vicatcu/BME680_Breakout/BME680/Board_with_RefDes.png

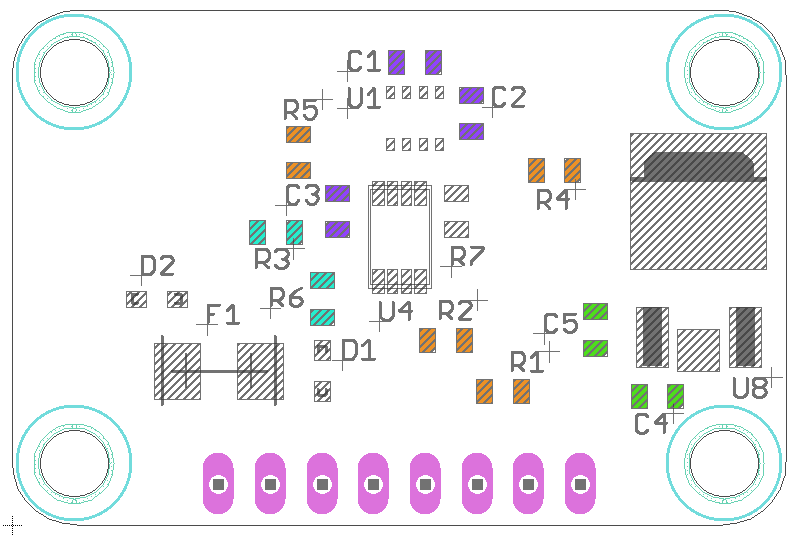
BME680/Board_with_RefDes.png
