vicatcu/BME680_Breakout/BME680/BOM.xlsx

LI | Qty | Designators | Manufacturer P/N | CType | Description
1 | 1 | U4 | NXP PCA9515ADP,118 | IC | I2C Multiplexer
2 | 1 | F1 | Bel Fuse Inc 0ZCG0014FF2C | Misc | PTC resettable fuse
3 | 1 | D2 | Diodes Inc. DDZ3V3BSF-7 | Diode | 3.43V Zener Diode
4 | 1 | D1 | Fairchild Semiconductor 1N4148WS | Diode | 1N4148 Diode
5 | 1 | C4, C5 | Kemet C0805C106K8PACTU | Capacitor | 10uF 0805 Capacitor
6 | 1 | U1 | Bosch Sensortec BME680 | Sensor | VOC Sensor
7 | 1 | U8 | STMicroelectronics LD1117DT33CTR | Power | 3.3V Regulator
8 | 3 | C1, C2, C3 | Yageo CC0805ZRY5V9BB104 | Capacitor | 0.1uF 0805 Capacitor
9 | 2 | R3, R6 | Yageo RC0805JR-0710KL | Resistor | 10k 0805 Resistor
10 | 1 | JP1 | 4UCON 00811 | Header | 1x8 Male Header
11 | 4 | R1, R2, R4, R5 | Yageo RC0805JR-074K7L | Resistor | 4.7kOhm 0805 Resistor
