vicatcu/BME680_Breakout/BME680_Breakout.brd

## EAGLE design BME680_Breakout.brd (2017-03-06)

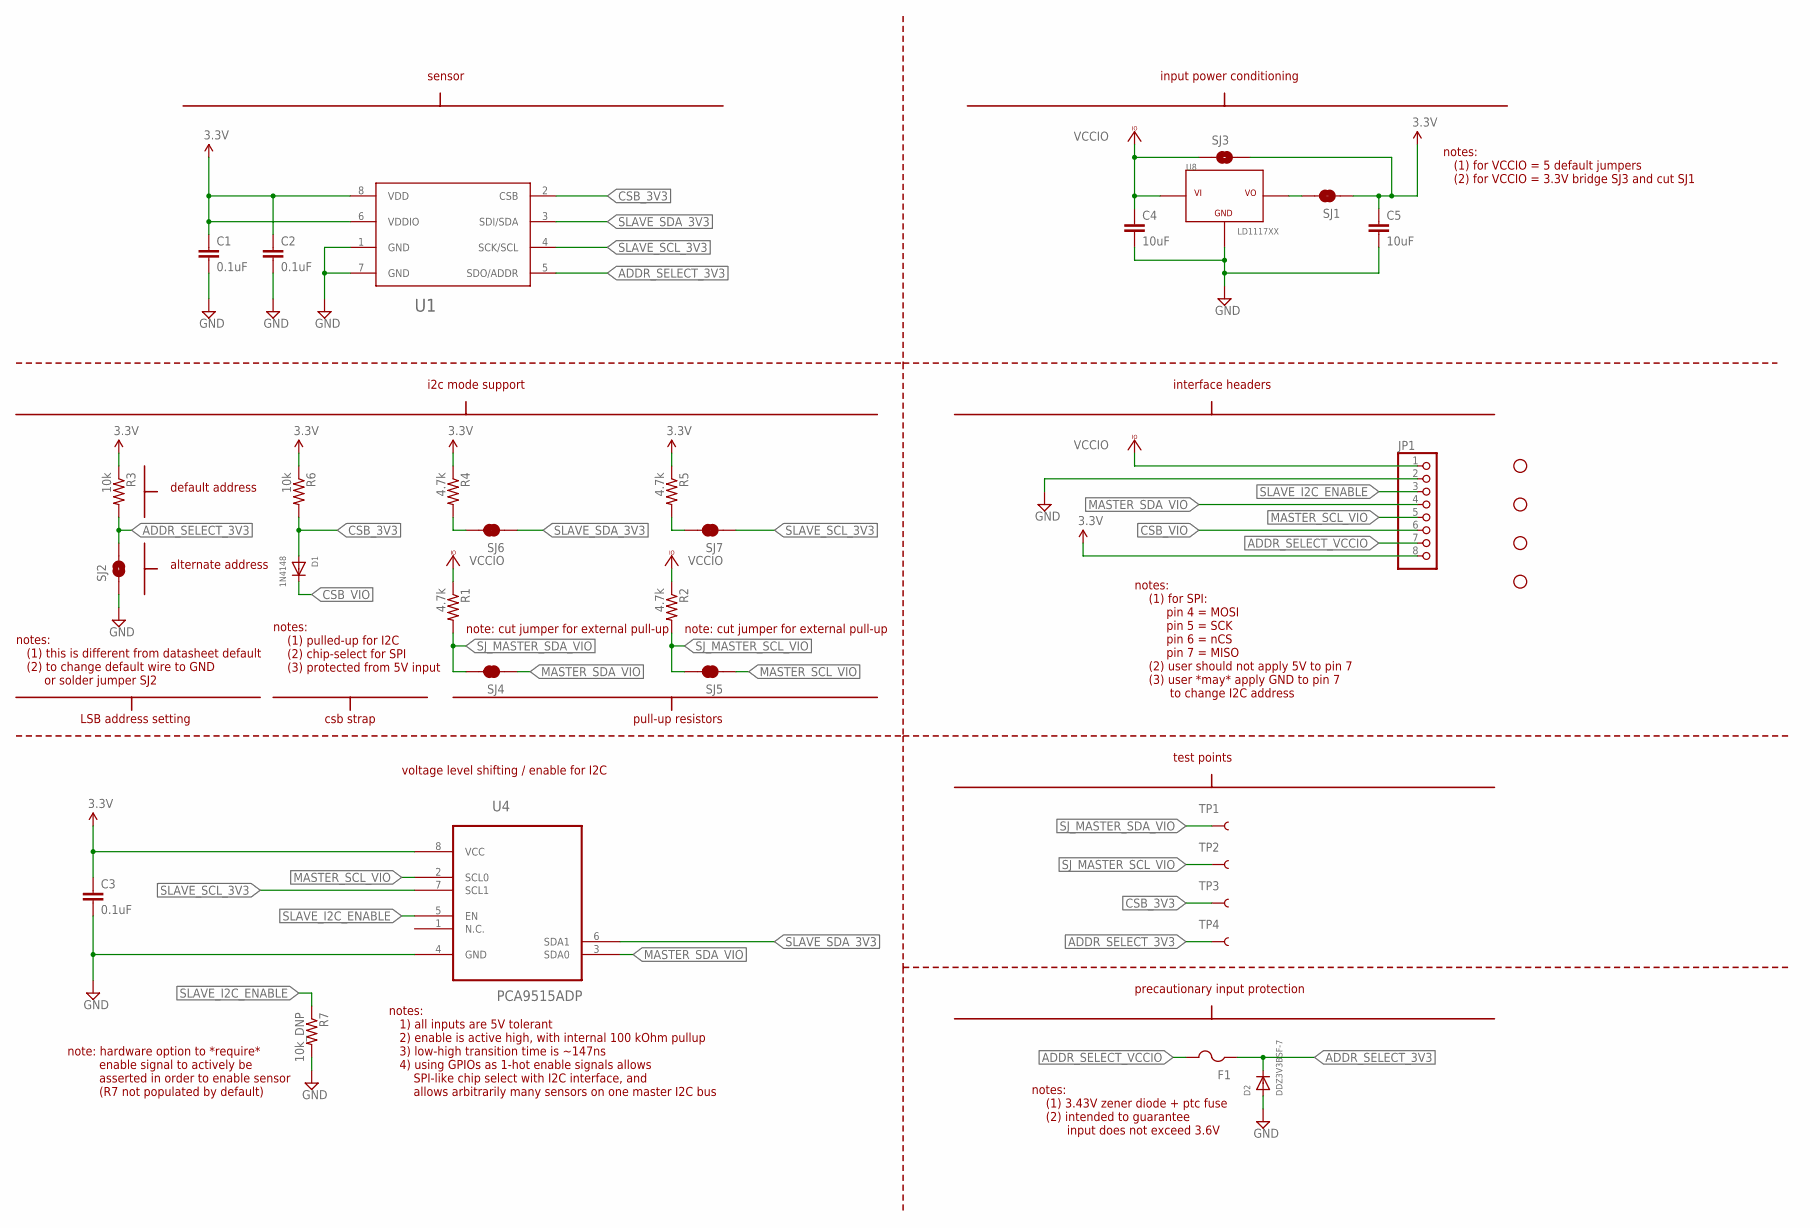
[picture p2: schematic BME680_Breakout.sch]

Parts:
C1, C2, C3: 0.1uF; 0805
C4, C5: 10uF; 0805
D1: 1N4148; SOD-323F
D2: DDZ3V3BSF-7; SOD-323F
F1: PTCFUSE-1812; 1812
JP1: PINHD-1X8; 1X08
R1, R2, R4, R5: 4.7k; 0805
R3, R6: 10k; 0805
R7: 10k_DNP; 0805
SJ1, SJ4, SJ5, SJ6, SJ7: JUMPER-PAD-2-NC_BY_TRACE; PAD-JUMPER-2-NC_BY_TRACE_YES_SILK
SJ2: JUMPER-PAD-2-NOYES_SILK; PAD-JUMPER-2-NO_YES_SILK
SJ3: SOLDERJUMPERNC2; SJ_2S-NOTRACE
STANDOFF1, STANDOFF2, STANDOFF3, STANDOFF4: STAND-OFF
TP1, TP2, TP3, TP4: TEST-POINT3X4; PAD.03X.04
U1: BME680
U4: PCA9515ADP; SOT505-1
U8: LD1117XX; DPAK

Connections:
3.3V: C1.1, C2.1, C3.1, C5.1, JP1.8, R3.1, R4.1, R5.1, R6.1, SJ1.1, SJ3.2, U1.6 (VDDIO), U1.8 (VDD), U4.8 (VCC)
ADDR_SELECT_3V3: D2.C, F1.1, R3.2, SJ2.2, TP4.P$1, U1.5 (SDO/ADDR)
ADDR_SELECT_VCCIO: F1.2, JP1.7
CSB_3V3: D1.A, R6.2, TP3.P$1, U1.2 (CSB)
CSB_VIO: D1.C, JP1.6
GND: C1.2, C2.2, C3.2, C4.2, C5.2, D2.A, JP1.2, R7.2, SJ2.1, U1.1 (GND), U1.7 (GND), U4.4 (GND), U8.1 (GND)
MASTER_SCL_VIO: JP1.5, SJ5.1, U4.2 (SCL0)
MASTER_SDA_VIO: JP1.4, SJ4.1, U4.3 (SDA0)
unnamed: SJ1.2, U8.4 (VO)
unnamed: R4.2, SJ6.2
unnamed: R5.2, SJ7.2
SJ_MASTER_SCL_VIO: R2.2, SJ5.2, TP2.P$1
SJ_MASTER_SDA_VIO: R1.2, SJ4.2, TP1.P$1
SLAVE_I2C_ENABLE: JP1.3, R7.1, U4.5 (EN)
SLAVE_SCL_3V3: SJ7.1, U1.4 (SCK/SCL), U4.7 (SCL1)
SLAVE_SDA_3V3: SJ6.1, U1.3 (SDI/SDA), U4.6 (SDA1)
VCCIO: C4.1, JP1.1, R1.1, R2.1, SJ3.1, U8.3 (VI)

Notes on the sheet:
i2c mode support
pull-up resistors
LSB address setting
csb strap
sensor
alternate address
default address
input power conditioning
interface headers
voltage level shifting / enable for I2C
notes: (1) pulled-up for I2C (2) chip-select for SPI (3) protected from 5V input
notes: 1) all inputs are 5V tolerant 2) enable is active high, with internal 100 kOhm pullup 3) low-high transition time is ~147ns 4) using GPIOs as 1-hot enable signals allows SPI-like chip select with I2C interface, and allows arbitrarily many sensors on one master I2C bus
notes: (1) for SPI: pin 4 = MOSI pin 5 = SCK pin 6 = nCS pin 7 = MISO (2) user should not apply 5V to pin 7 (3) user *may* apply GND to pin 7 to change I2C address
notes: (1) this is different from datasheet default (2) to change default wire to GND or solder jumper SJ2
notes: (1) for VCCIO = 5 default jumpers (2) for VCCIO = 3.3V bridge SJ3 and cut SJ1
note: cut jumper for external pull-up
note: hardware option to *require* enable signal to actively be asserted in order to enable sensor (R7 not populated by default)
test points
precautionary input protection
notes: (1) 3.43V zener diode + ptc fuse (2) intended to guarantee input does not exceed 3.6V

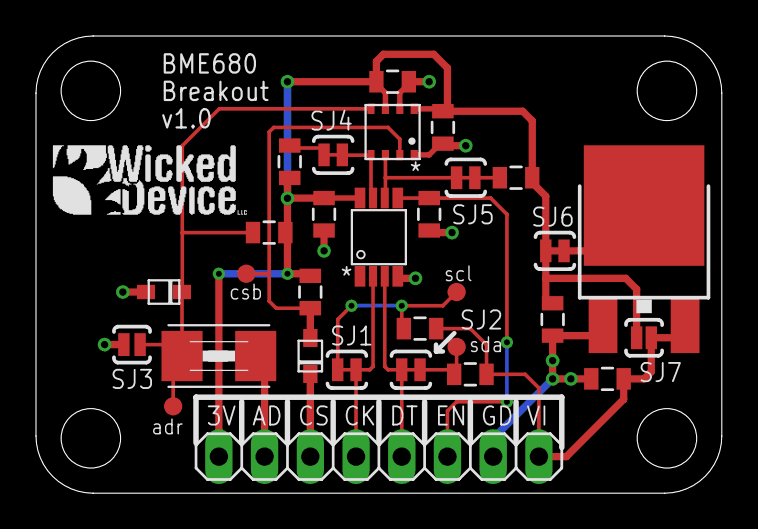
[picture p3: board BME680_Breakout.brd from above]

Board: 2 copper layers, 38.1 x 25.4 mm, 35 parts (0 on the bottom side), 17 nets.

Other parts of the board:
U$1: WICKEDLOGOTYPE2
