vicatcu/BME680_Breakout/(threads)

Thread 2 (2017-08-15):

Fails to compile for some non-AVR targets (e.g. ESP8266)

jwende, 2017-08-15:
It goes down to BME680_Library::i2c_read and the usage of the I2C read methods from <Wire.h>.
The length field is defined as uint16_t but <Wire.h> is using a signature with uint8_t.
I did a cast to uint8_t - but I guess it isn't a good idea.

  Wire.beginTransmission(dev_id);                          // START+SLA+W
  Wire.write(reg_addr);                                    // REG
  Wire.endTransmission(false);                             // STOP (false would be REP START)
  Wire.requestFrom(dev_id, (uint8_t)len,  1U);                      // SLA+R and STOP

skaringa, 2017-10-28:
Same issue here. Regarding to the documentation of Wire.requestFrom at https://www.arduino.cc/en/Reference/WireRequestFrom the last parameter is a boolean. So I patched the code this way:

    Wire.beginTransmission(dev_id);  // START+SLA+W
    Wire.write(reg_addr);  // REG
    Wire.endTransmission(false);  // STOP (false would be REP START)
    Wire.requestFrom(dev_id, (size_t)len, true); // SLA+R and STOP

vicatcu, 2017-10-28:
@skaringa is this true in a fresh checkout of the repository for you? What Tools => Board target are you using. If I make the change you are suggesting it fails to compile for AVR.

vicatcu, 2017-10-28:
Looking it up, AVR's Wire implementation has [these variants](https://github.com/arduino/Arduino/blob/master/hardware/arduino/avr/libraries/Wire/src/Wire.h#L61-L65) of requestFrom:
 ```c
    uint8_t requestFrom(uint8_t, uint8_t);
    uint8_t requestFrom(uint8_t, uint8_t, uint8_t);
    uint8_t requestFrom(uint8_t, uint8_t, uint32_t, uint8_t, uint8_t);
    uint8_t requestFrom(int, int);
    uint8_t requestFrom(int, int, int);
```

... and ESP8266 has [these variants](https://github.com/esp8266/Arduino/blob/master/libraries/Wire/Wire.h#L64-L70):

```c
    size_t requestFrom(uint8_t address, size_t size, bool sendStop);
    uint8_t requestFrom(uint8_t, uint8_t);
    uint8_t requestFrom(uint8_t, uint8_t, uint8_t);
    uint8_t requestFrom(int, int);
    uint8_t requestFrom(int, int, int);
```

The one we _want_ to have invoked is:
```c
uint8_t requestFrom(uint8_t address, uint8_t quantity, uint8_t sendStop) // AVR
size_t requestFrom(uint8_t address, size_t size, bool sendStop); // ESP8266
```

If I cast all three arguments to (int) it seems to compile for both platforms...

vicatcu, 2017-10-28:
@jwende @skaringa I just pushed this change, please give it a try and let me know if it works for you, then I'll close this issue.

skaringa, 2017-10-28:
You are right, I'm using the library on esp8266!
The actual commit casting all three arguments to (int) works well.
Since the code is working on esp8266 now, you may add this architecture to library.properties:
`architectures=avr,esp8266`
Thank you very much!

vicatcu, 2017-10-28:
@skaringa cool, I've added it, thanks for helping out!

Closed 2017-10-28.

Thread 3 (2017-10-08):

Strange values received from breakout board.

windkh, 2017-10-08:
After running the example
(https://github.com/vicatcu/BME680_Breakout/tree/master/BME680_Library/examples/Basic/Basic.ino)
I am always receiving the same values. In addition to that the values seem to be incorrect:

`Opening port
Port open
BME Initialization...Succeeded!
Configuring Forced Mode...Succeeded!
Temperature(degC),Relative_Humidity(%),Pressure(hPa),Gas_Resistance(Ohms)
33.71,100.00,690.56,0
33.71,100.00,690.56,0
33.71,100.00,690.56,0
33.71,100.00,690.56,0
33.71,100.00,690.56,0
33.71,100.00,690.56,0
33.71,100.00,690.56,0
33.71,100.00,690.56,0
`

The hardware (http://www.watterott.com/de/BME680-Breakout) was attached to an Arduino Uno using 3.3V as VCC.

Any suggestions?
Thanks in advance.

BoschSensortec, 2017-10-09:
@windkh ,

There seems to be a bug in the library. We have reported an issue to the author. You can track the issue.
https://github.com/vicatcu/BME680_Breakout/issues/4

windkh, 2017-10-09:
Ok thanks. The following lib seems to work
https://github.com/DFRobot/DFRobot_BME680

windkh, 2017-10-22:
I created a pull request with changed i2c write and read functions.

Closed 2017-10-22.

Thread 4 (2017-10-09):

Bug in i2c_write and i2c_read.

BoschSensortec, 2017-10-09:
Hi @vicatcu ,

There seems to be a bug in the read and write functions.

Please find below the intended codes.
```c
int8_t BME680_Library::i2c_read(uint8_t dev_id, uint8_t reg_addr, uint8_t *reg_data, uint16_t len){
  int8_t ret = -1; /* Return 0 for Success, non-zero for failure */

  /*
   * The parameter dev_id can be used as a variable to store the I2C address of the device
   */

  /*
   * Data on the bus should be like
   * |------------+---------------------|
   * | I2C action | Data                |
   * |------------+---------------------|
   * | Start      | -                   |
   * | Write      | (reg_addr)          |
   * | Stop       | -                   |
   * | Start      | -                   |
   * | Read       | (reg_data[0])       |
   * | Read       | (....)              |
   * | Read       | (reg_data[len - 1]) |
   * | Stop       | -                   |
   * |------------+---------------------|
   */

  Wire.beginTransmission(dev_id);                          // START+SLA+W
  Wire.write(reg_addr);                                    // REG
  Wire.endTransmission(false);                             // STOP (false would be REP START)
  Wire.requestFrom(dev_id, len,  1U);                      // SLA+R and STOP

  // using the blink without delay pattern here
  const int32_t timeout = 1000;                            // wait for up to 1s
  uint32_t previousMillis = millis();
  uint32_t currentMillis = millis();
  uint8_t num_read = 0;
  boolean complete = false;

  while(!complete){   // loop until break because got all the bytes or timed out
    currentMillis = millis();

    if(Wire.available()){
      reg_data[num_read] = Wire.read();                         // DATA
      num_read++;     // increment read index
    }

    if(num_read == len){                              // read complete
      ret = 0;                            // good outcome
      complete = true;
    }
    else if ((currentMillis - previousMillis) >= timeout) {  // timeout
      complete = false;
    }
  }

  return ret;
}
```

```c
int8_t BME680_Library::i2c_write(uint8_t dev_id, uint8_t reg_addr, uint8_t *reg_data, uint16_t len){
  int8_t ret = -1; /* Return 0 for Success, non-zero for failure */

/*
 * The parameter dev_id can be used as a variable to store the I2C address of the device
 */

/*
 * Data on the bus should be like
 * |------------+---------------------|
 * | I2C action | Data                |
 * |------------+---------------------|
 * | Start      | -                   |
 * | Write      | (reg_addr)          |
 * | Write      | (reg_data[0])       |
 * | Write      | (....)              |
 * | Write      | (reg_data[len - 1]) |
 * | Stop       | -                   |
 * |------------+---------------------|
 */

  uint8_t num_written = 0;

 // Interleaving of register address and data is done by the API
  Wire.beginTransmission(dev_id); // starts queueing bytes to be written
  Wire.write(reg_addr);           // write the register address
  while(num_written < len){  // Queue the rest of the bytes
    Wire.write(reg_data[num_written]);      // write the register value
    num_written++;                  // increment the number of bytes written
  }

  if(0 == Wire.endTransmission()){  // actually sends the queued bytes
    // if endTransmission returns a non-zero result
    // it's some kind of error, otherwise it's good
    ret = 0;
  }

  return ret;
}
```

Closed 2017-10-28.

Thread 6 (2017-11-01):

getGasResistance sometimes returns very low values (<100Ohm)

windkh, 2017-11-01:
Comparing the values of a MQ-135 sensor with the values returned from a BME680 I noticed that the library for the BME680 sometimes returns very low values for the gas resistance. Very low means below 100 instead of the expected value of around 15000.

The green line of the following graph is the BME680 while the blue one comes from the MQ-135:
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
The graph shows values of the last 6 hours

Here are some lines from the log file:

2017-11-01_19:51:08 MYSENSOR_BME680_R 14476 Ohm
2017-11-01_19:51:19 MYSENSOR_BME680_T 27.1 °
2017-11-01_19:51:19 MYSENSOR_BME680_R 14396 Ohm
2017-11-01_19:51:30 MYSENSOR_BME680_P 1020.8 mbar
2017-11-01_19:51:40 MYSENSOR_BME680_H 36.7 %
2017-11-01_19:51:40 MYSENSOR_BME680_R 14456 Ohm
**2017-11-01_19:51:51 MYSENSOR_BME680_R 26 Ohm**
2017-11-01_19:52:01 MYSENSOR_BME680_R 14456 Ohm
2017-11-01_19:52:12 MYSENSOR_BME680_H 36.6 %
2017-11-01_19:52:12 MYSENSOR_BME680_R 14416 Ohm
2017-11-01_19:52:44 MYSENSOR_BME680_R 14486 Ohm
2017-11-01_19:52:54 MYSENSOR_BME680_H 36.7 %
2017-11-01_19:52:54 MYSENSOR_BME680_R 14476 Ohm
2017-11-01_19:53:18 MYSENSOR_BME680_R 14426 Ohm
2017-11-01_19:53:29 MYSENSOR_BME680_R 14104 Ohm
2017-11-01_19:53:39 MYSENSOR_BME680_H 36.6 %
2017-11-01_19:53:39 MYSENSOR_BME680_R 14171 Ohm
2017-11-01_19:53:50 MYSENSOR_BME680_H 36.7 %
2017-11-01_19:53:50 MYSENSOR_BME680_R 14258 Ohm
2017-11-01_19:54:00 MYSENSOR_BME680_H 36.8 %
2017-11-01_19:54:01 MYSENSOR_BME680_R 14287 Ohm

The sensor takes a measurement every 10 seconds.

vicatcu, 2017-11-01:
Interesting, seems like something the devs at https://github.com/BoschSensortec/BME680_driver might have some insight into. This library basically just exposes that library for the Arduino environment. I suppose it _could_ be a numerical issue in the porting, but it might also be a fundamental behavioral issue with the sensor. Would you mind cross-posting the issue to them?

windkh, 2017-11-01:
No not at all, feel free.
Are the driver files in your lib the latest ones from Bosch?

vicatcu, 2017-11-01:
@windkh I haven't synchronized with the Bosch repo since at Jul 20 at best looking at the commit log. It's not _quite_ as simple as copy pasting their files into the src/utility folder, but you can do a diff to see if anything jumps out at you and let me know?

windkh, 2017-11-01:
So you are not just taking a copy of their files? Why not?

windkh, 2017-11-01:
Well, I just compared the files and found only one small block added to one of the headers, the rest is identical. So I think everything should be ok so far.

#if defined(ARDUINO_ARCH_AVR)
	#define UINT8_C(v) ((uint8_t) v)
	#define INT8_C(v) ((int8_t) v)
	#define UINT16_C(v) ((uint16_t) v)
	#define INT16_C(v) ((int16_t) v)
	#define UINT32_C(v) ((uint32_t) v)
	#define INT32_C(v) ((int32_t) v)
	#include <stdint.h>
#endif

windkh, 2017-11-02:
Running the test over the night showed even negative values like -32768 and even one large negative number -21.........0000

vicatcu, 2017-11-02:
-32768 is interesting in so far as it is -2^15 (which is the most negative represent-able 16-bit 2's complement integer value)... are you just running the Basic example sketch. What is the code that is printing negative values?

windkh, 2017-11-02:
The code looked like:
float gasResistance = bme680.getGasResistance();
which was definately wrong. Right now I am testing with
uint32_t gasResistance = bme680.getGasResistance();
which looks better. So far no errors... I keep you informed.

windkh, 2017-11-02:
Hi, I think there is no problem with your library. Debug logs were ok.
Sorry for false alarm.

Closed 2017-11-02.
