vicatcu/BME680_Breakout/(commit log)

2015-12-10 initial schematic commit
    [BME680_Breakout.sch]
2015-12-10 added layout file (not started)
    [BME680_Breakout.brd]
2016-01-09 settled on i2c, renamed some signals, added level shifter logic
    [BME680_Breakout.brd, BME680_Breakout.sch]
2016-01-09 added some support for SPI and wired an 8-pin interface header
    [BME680_Breakout.brd, BME680_Breakout.sch]
2016-01-09 added input power regulator, still need bypass solution, reorganized schematic slightly
    [BME680_Breakout.brd, BME680_Breakout.sch]
2016-01-09 added pull-down hardware option to allow changing default behavior of i2c buffer
    [BME680_Breakout.brd, BME680_Breakout.sch]
2016-01-09 added a few internal test points
    [BME680_Breakout.brd, BME680_Breakout.sch]
2016-01-10 asded zener diode and ptc fuse to address select input
    [BME680_Breakout.brd, BME680_Breakout.sch]
2017-01-29 Initial sketch of driver
2017-01-29 initial routing of PCB
    [BME680_Breakout.brd, BME680_Breakout.sch]
2017-02-06 added silk screen to back side; added to solder jumpers; minor routing changes
    [BME680_Breakout.brd, BME680_Breakout.sch]
2017-03-06 moved component reference designators to tDocu, and labeled solder jumpers and test points on tPlace
    [BME680_Breakout.brd]
2017-04-15 a minimal start at integrating vendor code into an arduino library, at least compiles (though doesn't attept to use any of the vendor code yet)
    [BME680_Library.cpp, BME680_Library.h, Basic.ino]
2017-04-15 hacked common types in vendor files to do something different for arduino
2017-04-15 fixed obvious bugs; added a bit to the Basic example
    [BME680_Library.cpp, BME680_Library.h, Basic.ino]
2017-04-15 more updates, implemented I2C read function
2017-04-15 implemented i2c burst_read and i2c write
2017-04-15 have to call Wire.begin() in setup
2017-06-14 production stuff
    [BME680_Breakout_centroid.csv, BOM.xlsx]
2017-10-22 Replaced i2c read and write function according to succested code in https://github.com/vicatcu/BME680_Breakout/issues/4
    [BME680_Library.cpp]
2017-10-28 allows compilation for non-avr targets (like esp8266) to work. Works around differences between available signatures in Wire library for some platforms. Addresses #2
2018-03-22 updated to latest Bosch driver code, example compiles without error
